FritzenLab/breadboard-voltmeter/README.md

# breadboard-voltmeter
 a voltmeter with OLED display on a breadboard, using CH32V003
