FritzenLab/breadboard-voltmeter/breadboard-voltmeter-r00/breadboard-voltmeter-r00.kicad_pcb

## KiCad design breadboard-voltmeter-r00/breadboard-voltmeter-r00.kicad_pcb (2025-02-22)

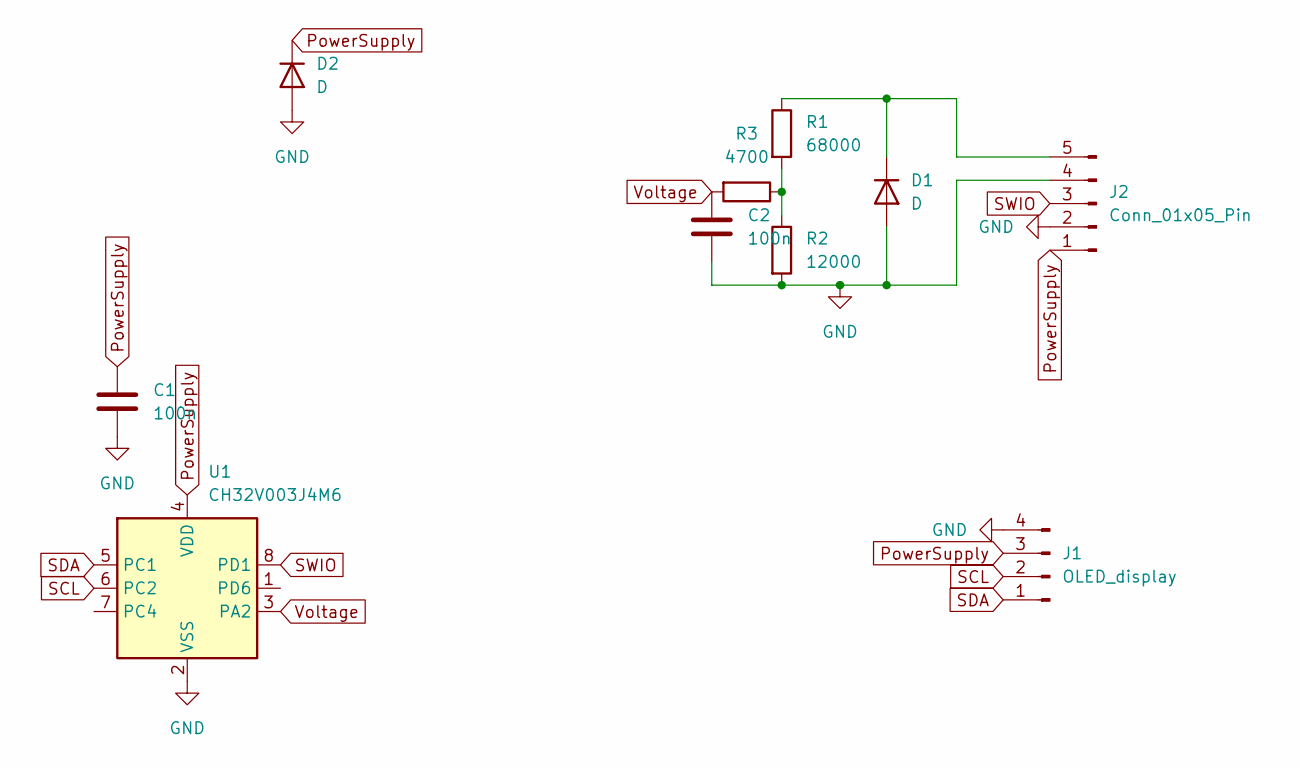
[picture p1: schematic breadboard-voltmeter-r00.kicad_sch]

Parts:
C1, C2: 100n; C_0805_2012Metric
D1, D2: D; D_MiniMELF
J1: OLED_display; PinHeader_1x04_P2.54mm_Vertical
J2: Conn_01x05_Pin; PinHeader_1x05_P2.54mm_Vertical
R1: 68000; R_0805_2012Metric
R2: 12000; R_0805_2012Metric
R3: 4700; R_0805_2012Metric
U1: CH32V003J4M6; SO-8_3.9x4.9mm_P1.27mm

Connections:
GND: C1.2, C2.2, D1.2 (A), D2.2 (A), J1.4, J2.2, J2.4, R2.2, U1.2 (VSS)
unnamed: D1.1 (K), J2.5, R1.1
unnamed: R1.2, R2.1, R3.1
PowerSupply: C1.1, D2.1 (K), J1.3, J2.1, U1.4 (VDD)
SCL: J1.2, U1.6 (PC2)
SDA: J1.1, U1.5 (PC1)
SWIO: J2.3, U1.8 (PD1)
Voltage: C2.1, R3.2, U1.3 (PA2)

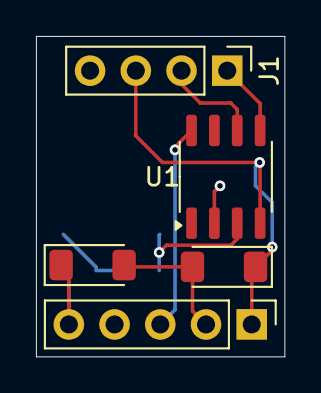
[picture p2: board breadboard-voltmeter-r00.kicad_pcb from above]

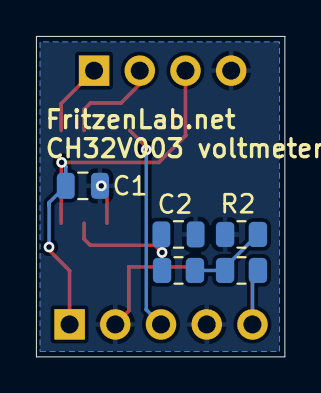
[picture p3: board breadboard-voltmeter-r00.kicad_pcb from below]

Board: 2 copper layers, 13.8 x 17.8 mm, 10 parts (5 on the bottom side), 8 nets.
