FritzenLab/breadboard-voltmeter/(commit log)

2025-01-31 added Kicad schematics
    [breadboard-voltmeter-r00.kicad_pcb, breadboard-voltmeter-r00.kicad_sch]
2025-01-31 started schematics
    [breadboard-voltmeter-r00.kicad_sch]
2025-01-31 created PCB
    [breadboard-voltmeter-r00.kicad_pcb, breadboard-voltmeter-r00.kicad_sch]
2025-02-01 finished design, ready to production
    [breadboard-voltmeter-r00-B_Cu.gbr, breadboard-voltmeter-r00-B_Mask.gbr, breadboard-voltmeter-r00-B_Paste.gbr, breadboard-voltmeter-r00-B_Silkscreen.gbr, breadboard-voltmeter-r00-Edge_Cuts.gbr, breadboard-voltmeter-r00-F_Cu.gbr, breadboard-voltmeter-r00-F_Mask.gbr, breadboard-voltmeter-r00-F_Paste.gbr]
2025-02-21 updated resistive divider values
    [breadboard-voltmeter-r00.kicad_sch]
2025-02-22 edited schematics
    [breadboard-voltmeter-r00.kicad_pcb]
2026-10-05 added fully functioning Platformio code
    added fully functioning Platformio code, removed tentative Arduino code.
